harrisonkay2112/esp32-rfid-authenticator/docs/validation.md

# Validation notes

## Scope

Repository preparation included source review, removal of personal configuration from the published copy, and review of locally installed library APIs. The original local checkpoint remains outside version control.

The published copy uses ASCII Tab and newline writes for both keyboard transports. This avoids passing raw HID usage IDs to the BLE library's ASCII `write()` API and avoids relying on conflicting USB/BLE key macros. The profile count is calculated from the configured array.

## Hardware validation history

**The device was built, wired, and operated successfully on physical hardware in spring 2026.**
The USB path was working on April 30, 2026; BLE output and profile selection on May 1, 2026. The complete authentication flow ran end to end on the board: scanning a card,
rejecting an unrecognized UID, entering a PIN on the keypad with masked LCD feedback, triggering
the three-failure lockout, browsing credential profiles, and typing the selected username and
password to a host over the keyboard interface.

Development followed an incremental bring-up order. Each peripheral was proven on its own before
integration, with separate test sketches for the MFRC522 reader, the matrix keypad, and the buzzer,
followed by an integrated checkpoint build. Those sketches stay out of version control because the
original checkpoint carried personal account values.

**Scope note for everything below.** The September 2026 work was a publication pass: source review,
credential sanitization, documentation, and a fresh compile. No board was wired up during that pass.
Where this document says a check was "not re-run," it means not re-run *at publication time* — it
does not mean the behavior was never observed on hardware.

## As-built hardware configuration

Recorded from the original build. Items marked *unconfirmed* were never measured or read directly
and should be checked before anyone reproduces this.

| Item | As built |
| --- | --- |
| Build surface | Full-size solderless breadboard with jumper wires; male-to-male wires to the keypad connector |
| Power source | USB only. (A separate MB102 + 9V supply was started but never wired or tested.) |
| MFRC522 supply | 3.3V rail |
| LCD supply | `VIN` |
| DS1307 supply | `VIN`. It was first tried on 3.3V and was not detected on the bus — the DS1307 is specified for 4.5–5.5V. |
| `VIN` actual voltage | **Unconfirmed.** `VBUS` is the documented 5V-from-USB pin; whether `VIN` carries ~5V on USB power was never measured. |
| Level shifting | None. A4/A5 go directly to the LCD and RTC. See the known electrical risk in the README limitations. |
| External I2C pull-ups | None added. Whether the modules carry onboard pull-ups, and their values, was **unconfirmed.** |
| Buzzer | Active buzzer (fixed tone when driven HIGH), driven directly from `D3` to GND. No transistor, no series resistor. Current draw at 3.3V was never measured. |
| LCD | 20x4 (LCD2004) with pre-soldered I2C backpack, responding at `0x27`. That address is consistent with a PCF8574, but the chip marking was **unconfirmed.** |
| RTC | DS1307 module, 5-pin (GND, VCC, SDA, SCL, SQW) with coin cell, found at `0x68` |
| Keypad | 4x4 with ribbon cable to an 8-pin connector. Membrane vs. mechanical **unconfirmed.** |
| Unused pins | MFRC522 `IRQ` and DS1307 `SQW` are not connected |

## Build status

A local Arduino CLI compile completed successfully on September 10, 2026 with the demonstration configuration:

- Target: `arduino:esp32:nano_nora` (Arduino Nano ESP32).
- Board package: `arduino:esp32` version `2.0.18-arduino.5`.
- Library versions: listed in the README.
- Program storage: 816,593 bytes of 3,145,728 bytes (25%).
- Static/global RAM: 49,152 bytes of 327,680 bytes (15%). This is not a measurement of peak runtime RAM use.

The original board has been identified as an Arduino Nano ESP32. This compile uses its default Arduino pin-numbering mode. The installed HijelHID library advertises a newer upstream core requirement even though this local combination compiled. Compatibility with other core versions and runtime behavior remains to be checked.

The compiler reported that LiquidCrystal I2C declares AVR compatibility while this target uses ESP32. The build succeeded, but LCD operation still requires a hardware check.

Reproduction command with Arduino CLI on PATH and the dependencies installed in the Arduino sketchbook:

```bash
arduino-cli compile --fqbn arduino:esp32:nano_nora firmware/esp32_authenticator
```

The public UID and PIN ciphertexts were independently decrypted and verified against their documented demonstration values. The publication files were also checked against the original local account values and AES material; no original values were included.

No firmware was uploaded during the September 2026 publication pass, and no board was wired up for it. The hardware behavior described above was established earlier, during development.

## Behavior reference and re-test checklist

These behaviors were exercised on hardware during original development. The table is kept as a
re-test checklist for anyone rebuilding the device or changing the firmware — it is a specification
of expected behavior, not a transcript of a specific test session.

| Check | Expected behavior |
| --- | --- |
| Boot | LCD reaches the idle screen and Serial prints a timestamped boot event |
| Unrecognized card | Denial message and failure buzzer pattern; PIN count does not increase |
| Recognized card | PIN entry screen appears |
| PIN editing | Typed characters are masked; `*` removes the last character; `#` submits |
| Wrong PIN once or twice | Failure count increases and access is denied |
| Third wrong PIN | Lockout begins and the display shows remaining time |
| Lockout expiry | After the RTC-based interval, failure count clears and scanning resumes |
| Correct PIN | Profile menu opens |
| Profile navigation | `4` and `6` wrap through configured profiles |
| Cancel profile | Returns to idle without typing credentials |
| USB profile output | Demo username, Tab, demo password, Enter reach a disposable test field |
| BLE profile output | After pairing, the same sequence reaches a disposable test field |
| Mode toggle | Holding `A` while the main loop runs changes the selected transport |
| Reboot during lockout | RAM state resets; this demonstrates a known limitation |

Confirm that no credentials are entered into an unintended window. The firmware cannot identify the focused application or validate a server response.

## Evidence summary

| Check | Status | Evidence or limitation |
| --- | --- | --- |
| Compile with the documented local toolchain | Passed | Arduino CLI exit code 0 and storage/RAM summary above |
| Public demonstration ciphertexts | Passed | Independent decryption matched the documented UID and PIN |
| Publication credential scan | Passed | No original account values or original AES key/IV in the publication files |
| Architecture and connection documentation | Source review | Derived from the published sketch rather than re-measured on the board |
| Nano header and signal mapping | Documentation review | Checked against the official pinout and installed board variant; Arduino pin-numbering mode required |
| Physical wiring and voltage compatibility | Verified on the original build | Worked on the assembled board; the published I2C power and buzzer drawings are reference circuits and should be checked against your own modules |
| RFID and keypad interactions on device | Verified on the original build | Card scan, UID rejection, and masked PIN entry all observed working on hardware |
| USB keyboard output on a host | Verified on the original build | Typing confirmed into a Notepad window on Windows. Real login pages were not used as targets. |
| BLE keyboard output on a host | Verified on the original build | Confirmed on Windows after the per-character write and raw-HID Tab/Enter fixes. Re-pairing was required after each reflash. |
| 3-strike lockout and timestamped auth log on device | **Unconfirmed** | Implemented in firmware and the system ran end to end, but these specific behaviors were never isolated and confirmed in their own test |
| Publication-time code changes (profile header, ASCII Tab/Enter writes) | Compiled only | Not run on hardware. The bench build sent Tab and Enter over BLE as raw HID codes `0x2B` and `0x28` |
| RTC timekeeping | Verified standalone | The dedicated RTC test printed correct time once per second |
| Replay resistance or secure-boot enforcement | Not established | No implementation/configuration or attack-test evidence included |

## Test record template

Use a separate record for each hardware session. Mark outcomes as Pass, Fail, or Not run; record what was observed rather than copying the expected behavior.

```text
Date:
Firmware commit:
Board model and revision:
Board package and version:
Pin-numbering mode:
Library versions:
Wiring reference:
Host OS and keyboard layout:
Transport (USB or BLE):
Test case:
Expected behavior:
Observed behavior:
Outcome:
Evidence (sanitized serial capture, photo, or video):
Notes / follow-up:
```

## Useful boundary checks

- Submit an empty PIN, delete from an empty PIN, and attempt a seventh character.
- Enter letter keys during PIN entry to confirm the current routine accepts them.
- Verify that an invalid card does not increase the failed PIN count.
- After a wrong PIN, authenticate correctly but cancel profile selection; confirm that cancellation does not reset the previous count.
- Leave PIN entry or profile selection idle and confirm the current lack of a timeout.
- Disconnect the host before selecting a profile. Record what the device displays and whether any output is received; the access-granted message alone is not proof of delivery.
- After lockout expires, distinguish authentication readiness from the LCD content. `checkLockout()` clears the flags without calling `showIdle()`, so the prior display can remain until another UI action redraws it.

These are edge cases worth probing on a rebuild. They are listed as open questions about the current implementation, not as defects observed on the original build.
