harrisonkay2112/esp32-rfid-authenticator/firmware/esp32_authenticator/credentials.example.h

#pragma once

// Public demonstration values only. These do not protect real credentials.
// To customize, copy this file to credentials.local.h, which Git ignores.
// AES-128-CBC ciphertext below uses one zero-padded 16-byte block per value.
// Demonstration UID: 04 A1 B2 C3. Demonstration PIN: 123456.
byte aesKey[16] = {
  0x00, 0x01, 0x02, 0x03, 0x04, 0x05, 0x06, 0x07,
  0x08, 0x09, 0x0A, 0x0B, 0x0C, 0x0D, 0x0E, 0x0F
};
byte aesIV[16] = {
  0x10, 0x11, 0x12, 0x13, 0x14, 0x15, 0x16, 0x17,
  0x18, 0x19, 0x1A, 0x1B, 0x1C, 0x1D, 0x1E, 0x1F
};
byte encryptedUID[16] = {
  0x10, 0xED, 0x0A, 0xFA, 0xC8, 0x0F, 0xED, 0x3C,
  0x8E, 0x9A, 0x5C, 0xAE, 0x84, 0x38, 0x4D, 0xC3
};
byte encryptedPIN[16] = {
  0x4C, 0x09, 0x19, 0xB3, 0x97, 0x5A, 0x97, 0x90,
  0x29, 0x98, 0x64, 0x32, 0x0D, 0xE4, 0xB6, 0xEA
};

struct Profile {
  const char* name;
  const char* username;
  const char* password;
};

Profile profiles[] = {
  {"Demo One", "demo1@example.com", "demo-password-1"},
  {"Demo Two", "demo2@example.com", "demo-password-2"},
  {"Demo Three", "demo3@example.com", "demo-password-3"},
  {"Demo Four", "demo4@example.com", "demo-password-4"}
};
