harrisonkay2112/esp32-rfid-authenticator/(commit log)

2026-09-10 Publish ESP32 RFID and PIN authenticator prototype
2026-09-10 Add Nano ESP32 pin-to-pin wiring guides
2026-10-12 Correct validation scoping: device was hardware-validated during development
    The September 2026 publication pass was documentation and credential
    sanitization only, and its notes were scoped to that pass. Read from outside,
    that wording implied the project had never been run on hardware, which is not
    the case.
    - State plainly in the README that the device was built and operated on
    physical hardware in mid-2026, with the full authentication flow exercised
    end to end on the wired board.
    - Record the incremental bring-up history: each peripheral proven on its own
    before integration.
    - Add a scope note to validation.md so "not re-run" is understood as
    "not re-run at publication time," n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
2026-10-12 Document as-built hardware configuration and known electrical risk
    Confirmed details recovered from the original build notes.
    - Record the as-built configuration: breadboard, USB power, MFRC522 on 3.3V,
    LCD and DS1307 on VIN, active buzzer driven directly from D3.
    - Mark genuinely unverified items as unconfirmed rather than silently omitting
    them: VIN voltage was never measured, the PCF8574 marking was never read,
    onboard pull-up presence was never checked, keypad construction unknown.
    - Add a known electrical risk: no level shifting between 3.3V I2C and modules
    powered from VIN, on a part that is not 5V-tolerant.
    - Explain that secure boot was skipped deliberately because enabling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
2026-10-12 Align hardware guide with the as-built prototype
    The hardware guide still described the power arrangement and buzzer as unknown
    and contradicted the corrected README and validation notes.
    - Label the I2C and buzzer drawings as recommended rebuild circuits and state
    how the prototype differed: LCD and DS1307 on VIN with no level shifter, and
    a two-terminal active buzzer wired directly to D3.
    - Replace the "remaining checks" table with the known as-built status.
    - Update the buzzer drawing caption (SVG and PNG).
    - Fix the link to the renamed re-test checklist section.
    - State that two publication-time code changes (profile header, ASCII
    Tab/Enter writes) were compiled but not run on har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
2026-10-12 Correct wiring diagrams, add license, remove unused concept image
    - Rename the VUSB pin label to VBUS to match the Arduino Nano ESP32 pinout.
    - Narrow the module and connector graphics so they no longer overlap the pin
    labels, and re-render the four PNGs from their SVG sources.
    - Remove the unused conceptual overview image, which showed a generic ESP32
    dev board rather than the Nano ESP32 used in the build.
    - Note that the prototype was disassembled before publication, so there are
    no build photographs.
    - Add an MIT license.
